TobleMiner/PCIe-x2-M.2-Key-A_E-adapter/README.md

PCIe 2x M.2 A/E Key adapter
===========================

This adapter supports large-size M.2 Key A/E cards with two PCIe lanes.
It has been specifically designed for power-hungry 802.11ax 4x4 MIMO
cards with unusual form factors.

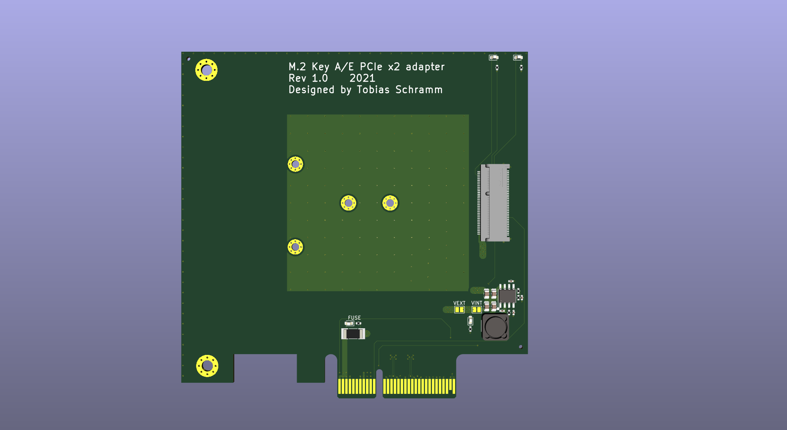
[picture p1: assets/pcb_top.png]
PCB top view
