TobleMiner/PCIe-x2-M.2-Key-A_E-adapter/rev1.0/schematic.pdf

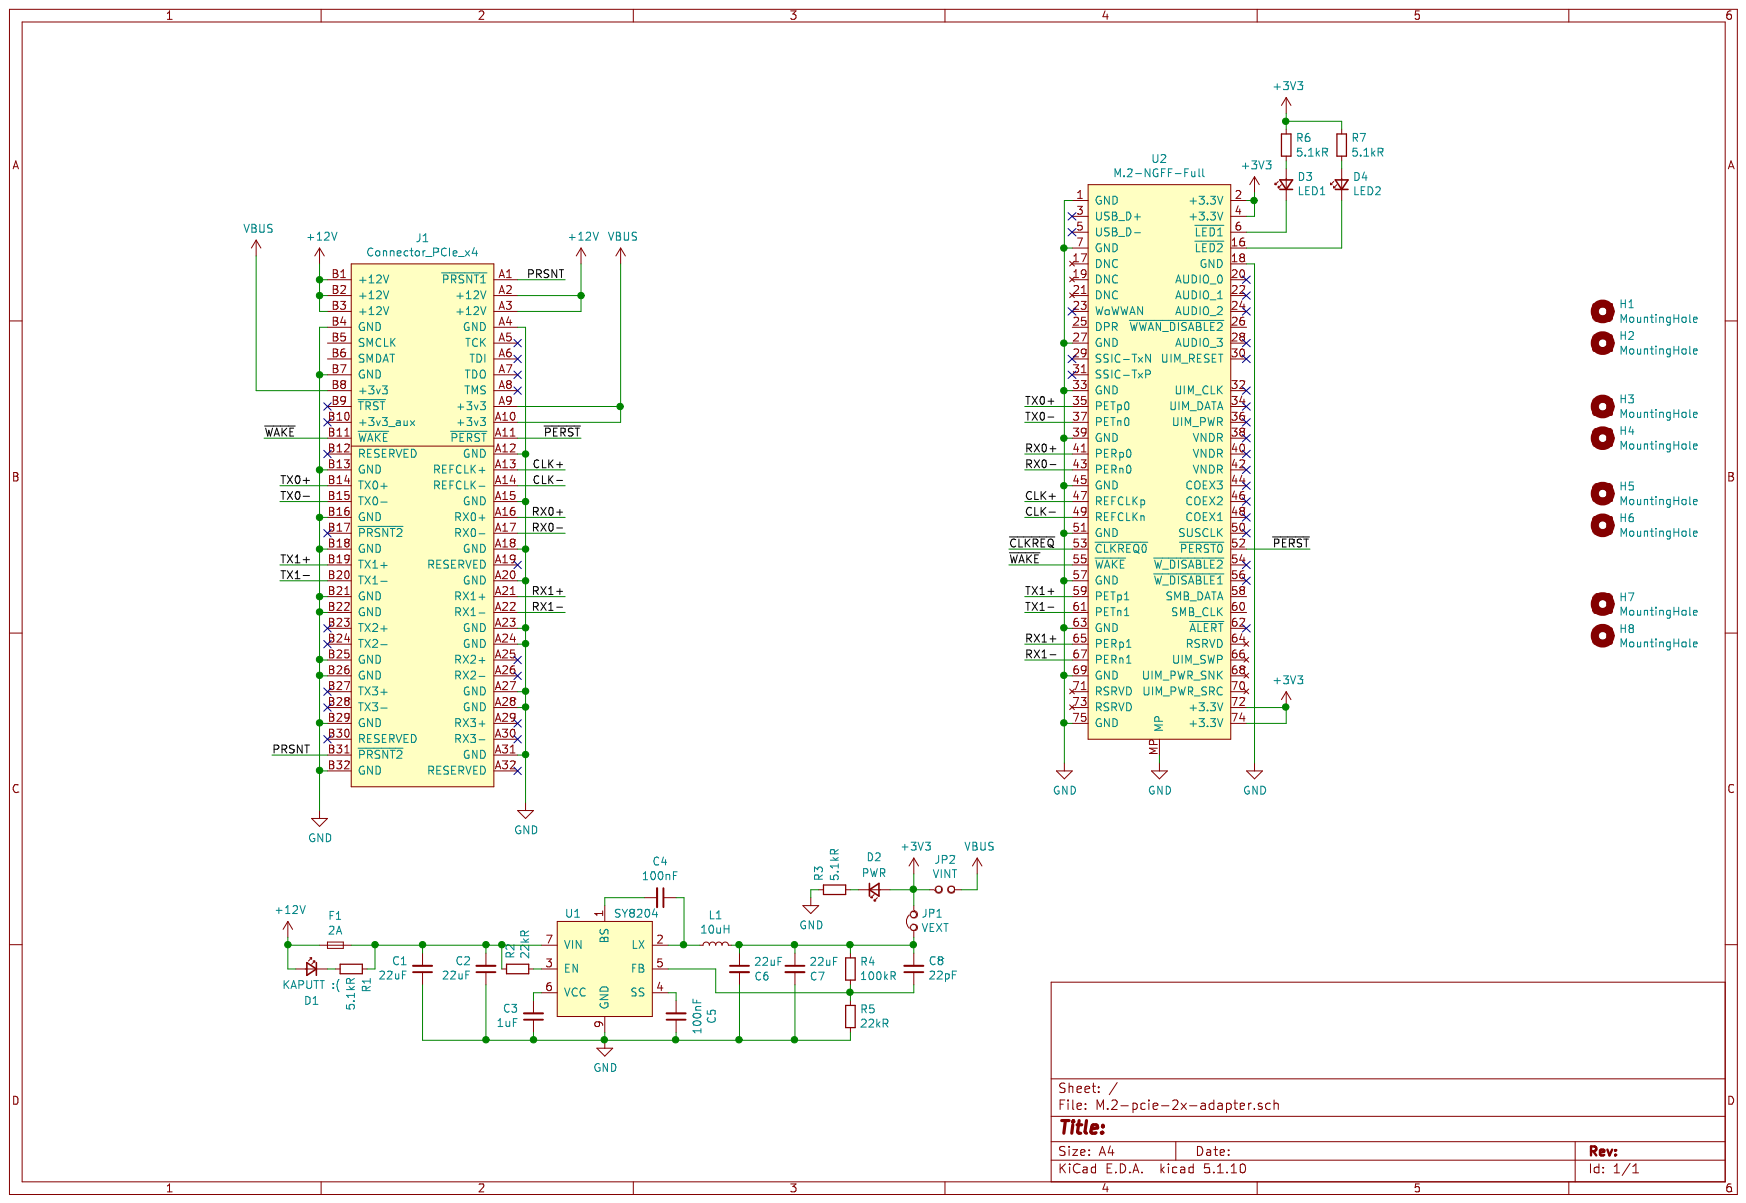
[picture p2: page 1]
