TobleMiner/PCIe-x2-M.2-Key-A_E-adapter/M.2-pcie-2x-adapter.kicad_pcb

## KiCad design M.2-pcie-2x-adapter.kicad_pcb (2021-10-16)

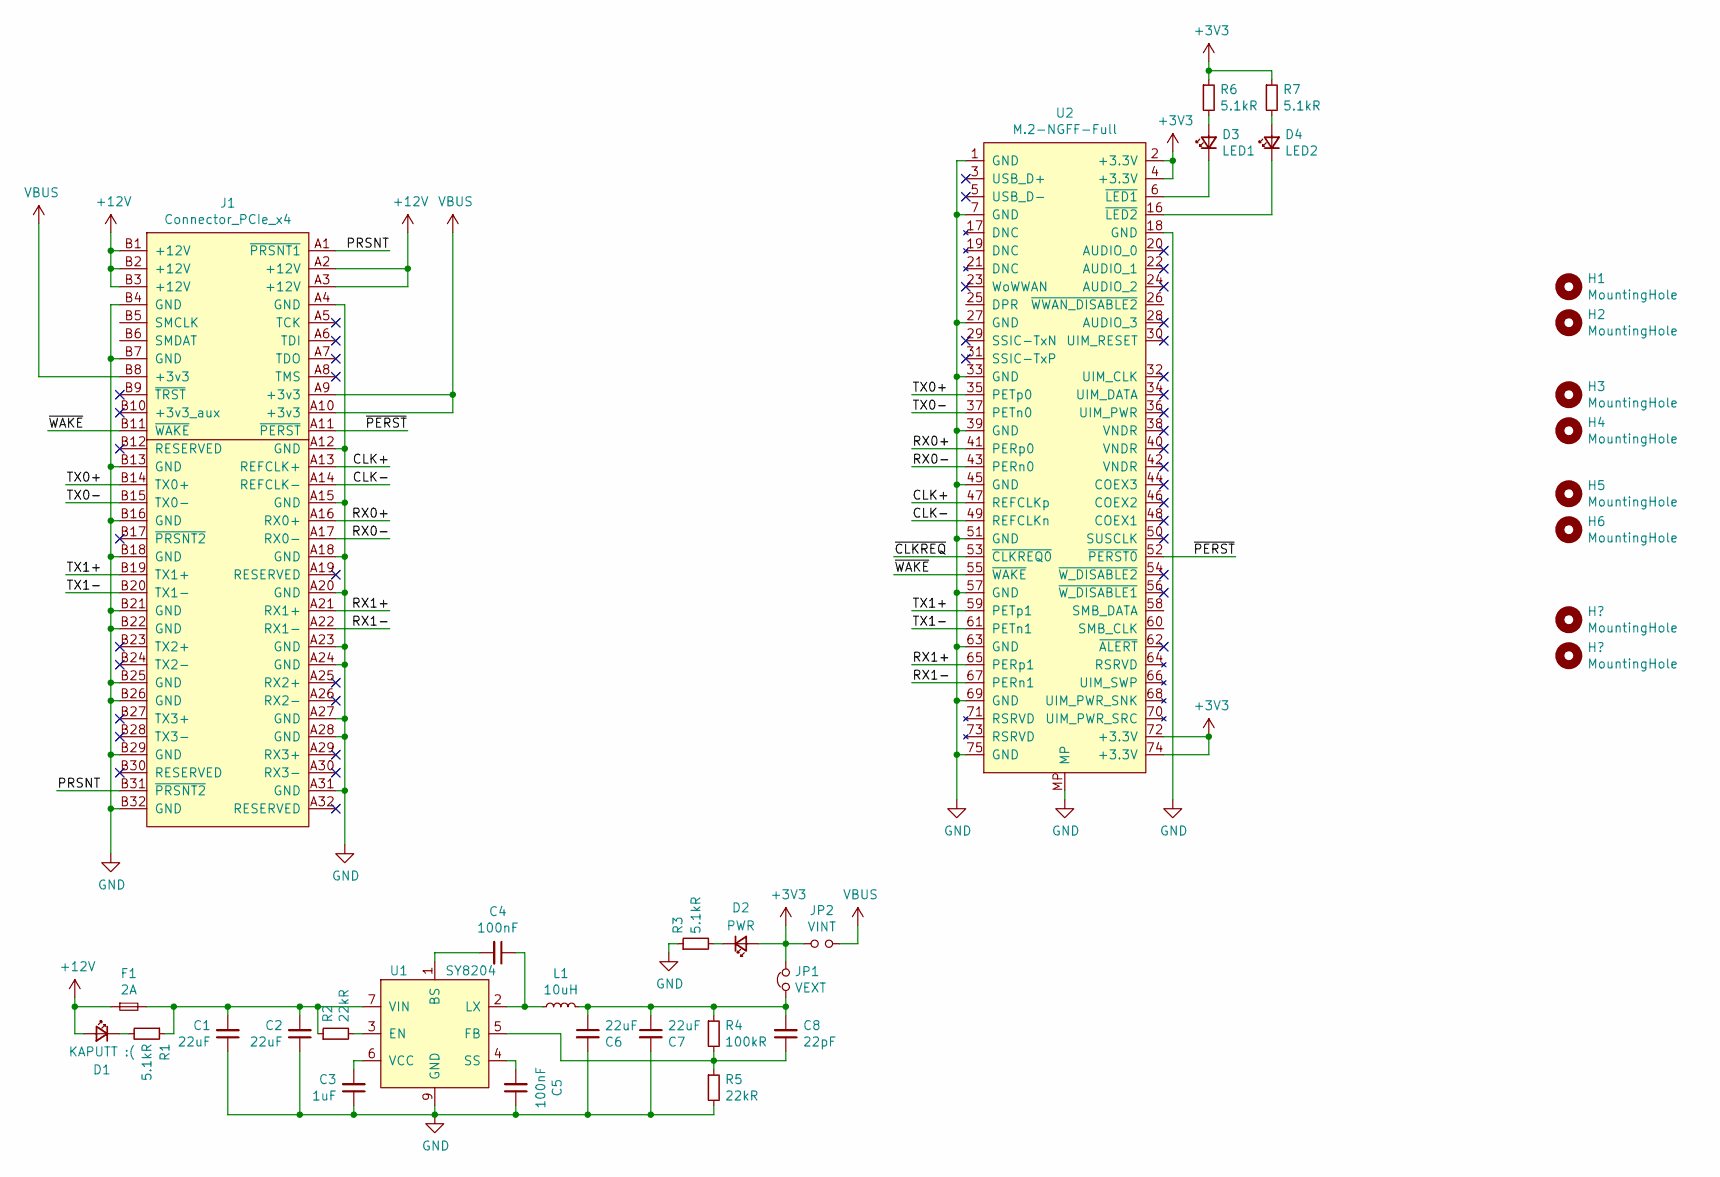
[picture p3: schematic M.2-pcie-2x-adapter.sch]

Parts:
C1, C2, C6, C7: 22uF; C_0805_2012Metric; LCSC C45783
C3: 1uF; C_0402_1005Metric; LCSC C52923
C4, C5: 100nF; C_0402_1005Metric
C8: 22pF; C_0402_1005Metric
D1: KAPUTT :(; LED_0603_1608Metric; LCSC C2286
D2: PWR; LED_0603_1608Metric; LCSC C72043
D3: LED1; LED_0603_1608Metric; LCSC C72038
D4: LED2; LED_0603_1608Metric; LCSC C2290
F1: 2A; Fuse_Littelfuse-NANO2-451_453; LCSC C99547
H1, H2: MountingHole; MountingHole_3.2mm_M3_Pad_Via
H3, H4, H5, H6: MountingHole; MountingHole_2.2mm_M2_Pad_Via
J1: Connector_PCIe_x4; BUS_PCIexpress_x4
JP1: VEXT; SolderJumper-2_P1.3mm_Bridged_Pad1.0x1.5mm
JP2: VINT; SolderJumper-2_P1.3mm_Open_Pad1.0x1.5mm
L1: 10uH; L_Sumida_CDMC6D28_7.25x6.5mm; LCSC C167223
R1, R3, R6, R7: 5.1kR; R_0402_1005Metric; LCSC C25905
R2, R5: 22kR; R_0402_1005Metric; LCSC C25768
R4: 100kR; R_0402_1005Metric; LCSC C25741
U1: SY8204; HSOP-8-1EP_3.9x4.9mm_P1.27mm_EP2.41x3.1mm_ThermalVias; LCSC C125895
U2: M.2-NGFF-Full; MDTXXXXXX001

Connections:
+3V3: D2.2 (A), JP1.2, JP2.2, R6.1, R7.1, U2.2 (+3.3V), U2.4 (+3.3V), U2.72 (+3.3V), U2.74 (+3.3V)
+12V: D1.2 (A), F1.1, J1.A2 (+12V), J1.A3 (+12V), J1.B1 (+12V), J1.B2 (+12V), J1.B3 (+12V)
/CLK+: J1.A13 (REFCLK+), U2.47 (REFCLKp)
/CLK-: J1.A14 (REFCLK-), U2.49 (REFCLKn)
/PRSNT: J1.A1 (~PRSNT1), J1.B31 (~PRSNT2)
/RX0+: J1.A16 (RX0+), U2.41 (PERp0)
/RX0-: J1.A17 (RX0-), U2.43 (PERn0)
/RX1+: J1.A21 (RX1+), U2.65 (PERp1)
/RX1-: J1.A22 (RX1-), U2.67 (PERn1)
/TX0+: J1.B14 (TX0+), U2.35 (PETp0)
/TX0-: J1.B15 (TX0-), U2.37 (PETn0)
/TX1+: J1.B19 (TX1+), U2.59 (PETp1)
/TX1-: J1.B20 (TX1-), U2.61 (PETn1)
/~CLKREQ: U2.53 (~CLKREQ0)
/~PERST: J1.A11 (~PERST), U2.52 (~PERST0)
/~WAKE: J1.B11 (~WAKE), U2.55 (~WAKE)
GND: C1.1, C2.1, C3.1, C5.1, C6.2, C7.2, J1.A4 (GND), J1.A12 (GND), J1.A15 (GND), J1.A18 (GND), J1.A20 (GND), J1.A23 (GND), J1.A24 (GND), J1.A27 (GND), J1.A28 (GND), J1.A31 (GND), J1.B4 (GND), J1.B7 (GND), J1.B13 (GND), J1.B16 (GND), J1.B18 (GND), J1.B21 (GND), J1.B22 (GND), J1.B25 (GND), J1.B26 (GND), J1.B29 (GND), J1.B32 (GND), R3.1, R5.2, U1.9 (GND), U2.1 (GND), U2.7 (GND), U2.18 (GND), U2.27 (GND), U2.33 (GND), U2.39 (GND), U2.45 (GND), U2.51 (GND), U2.57 (GND), U2.63 (GND), U2.69 (GND), U2.75 (GND), U2.MP
unnamed: C3.2, U1.6 (VCC)
unnamed: C4.1, L1.1, U1.2 (LX)
unnamed: C4.2, U1.1 (BS)
unnamed: C5.2, U1.4 (SS)
unnamed: C6.1, C7.1, C8.2, JP1.1, L1.2, R4.1
unnamed: C8.1, R4.2, R5.1, U1.5 (FB)
unnamed: D1.1 (K), R1.2
unnamed: D2.1 (K), R3.2
unnamed: D3.1 (K), U2.6 (~LED1)
unnamed: D3.2 (A), R6.2
unnamed: D4.1 (K), U2.16 (~LED2)
unnamed: D4.2 (A), R7.2
unnamed: R2.2, U1.3 (EN)
VBUS: J1.A9 (+3v3), J1.A10 (+3v3), J1.B8 (+3v3), JP2.1
VIN: C1.2, C2.2, F1.2, R1.1, R2.1, U1.7 (VIN), U1.8 (VIN)

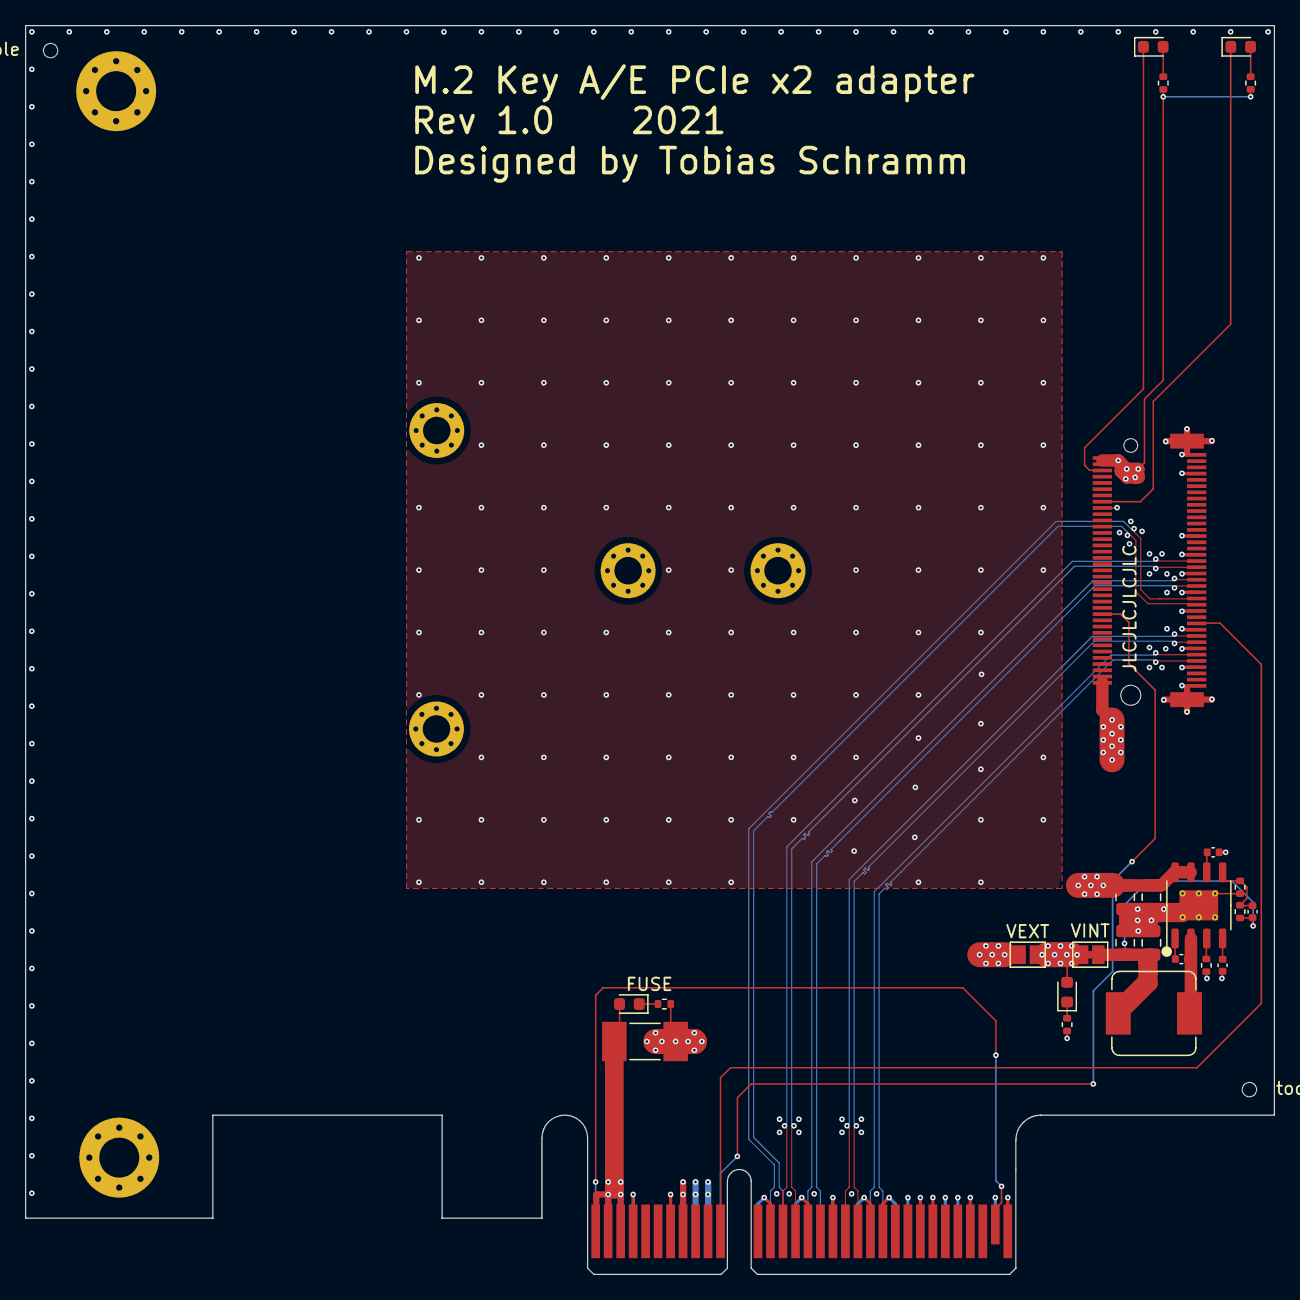
[picture p4: board M.2-pcie-2x-adapter.kicad_pcb from above]

Board: 4 copper layers, 100.0 x 100.0 mm, 34 parts (0 on the bottom side), 31 nets.

Other parts of the board:
H7, H8: MountingHole; ToolingHole_JLCSMT
