TobleMiner/PCIe-x2-M.2-Key-A_E-adapter/(commit log)

2021-10-16 Prepare for production
    [M.2-pcie-2x-adapter.kicad_pcb, M.2-pcie-2x-adapter.sch]
2021-10-16 Add 3D models to all parts
    [M.2-pcie-2x-adapter.kicad_pcb]
2021-10-16 Add rev1.0 artifacts
    [M.2-pcie-2x-adapter_bom_jlc.csv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]
